vmlrodrigues/WatchTower/(commit log)

2026-06-07 feat: adapt WatchTower for Sydney AEST/AEDT using Jaycar parts
    - Transmit buf_now_local instead of buf_now_utc so the TZ_INFO offset
    is actually applied to the WWVB signal (previously TZ_INFO had no
    effect on what was transmitted)
    - Set TZ_INFO to AEST-16AEDT-17,M10.1.0,M4.1.0/3 so a Central Time
    (UTC-6) clock displays correct Sydney time year-round
    - Set PIN_ANTENNA to GPIO4 for Keyestudio KS0413 board
    - Replace ArduinoMDNS (unmaintained) with ESPmDNS from ESP32 core
    - Rewrite README as a complete Jaycar build guide for Sydney
    - Add CLAUDE.md primer for AI-assisted development context
    - Add Sharp atomic clock product photo
    - Exclude tmp/ directory from git tracking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
    [WatchTower.ino]
2026-06-07 fix: show real Sydney time on web UI and serial output
    The web UI and serial log were displaying the fake UTC+16 offset time
    used internally for the WWVB trick rather than real Sydney time.
    Introduce buf_now_sydney computed from UTC + real AEST/AEDT offset
    (10h or 11h based on DST state) via gmtime_r, keeping buf_now_local
    (the fake UTC+16/+17 time) exclusively for the WWVB signal path.
    - Web UI time now shows e.g. "20:29 +1000 AEST" instead of "02:29 +1600 AEST"
    - Web UI date corrected to real Sydney date
    - Timezone label updated to "Australia/Sydney (AEST UTC+10)" / "(AEDT UTC+11)"
    - Last NTP Sync display corrected to real Sydney time
    - Serial output corrected to real Sydney time
    Co-Aut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
    [WatchTower.ino]
